denis-bisson/tusb2036-eval/README.md

Evaluation board for the TI TUSB2036 USB hub controller.
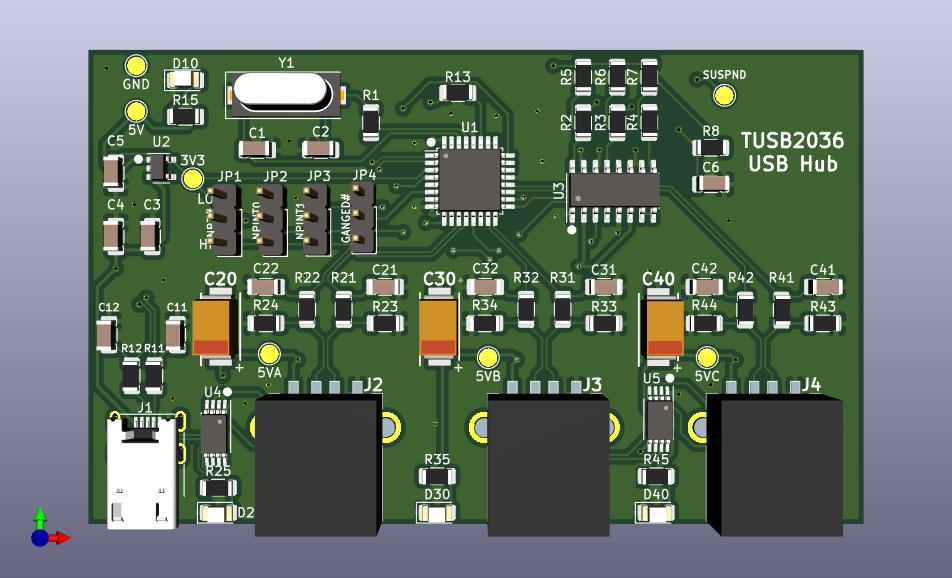
[picture p1: render.jpg]
Render
