denis-bisson/tusb2036-eval/bom.csv

Refs | value | Vendor | Vendor Part # | Price | datasheet | footprint
C1 | 22pF | Mouser | 710-885012009007 | 0.61 | https://www.mouser.com/datasheet/2/445/885012009007-1727300.pdf | Capacitor_SMD:C_1206_3216Metric
C10 | 22pF | Mouser | 710-885012009007 | 0.61 | https://www.mouser.com/datasheet/2/445/885012009007-1727300.pdf | Capacitor_SMD:C_1206_3216Metric
C11 | 22pF | Mouser | 710-885012009007 | 0.61 | https://www.mouser.com/datasheet/2/445/885012009007-1727300.pdf | Capacitor_SMD:C_1206_3216Metric
C2 | 22pF | Mouser | 710-885012009007 | 0.61 | https://www.mouser.com/datasheet/2/445/885012009007-1727300.pdf | Capacitor_SMD:C_1206_3216Metric
C20 | 120μF | Mouser | 74-293D127X96R3D2TE3 | 0.87 | https://www.mouser.com/datasheet/2/427/293d-1763499.pdf | Vishay:CAPPM7343X310N
C21 | 22pF | Mouser | 710-885012009007 | 0.61 | https://www.mouser.com/datasheet/2/445/885012009007-1727300.pdf | Capacitor_SMD:C_1206_3216Metric
C22 | 22pF | Mouser | 710-885012009007 | 0.61 | https://www.mouser.com/datasheet/2/445/885012009007-1727300.pdf | Capacitor_SMD:C_1206_3216Metric
C3 | 4.7μF | Mouser | 80-C1210C475J3N | 0.93 | https://www.mouser.com/datasheet/2/212/KEM_C1008_X8L_150C_SMD-1101219.pdf | Capacitor_SMD:C_1206_3216Metric
C30 | 120μF | Mouser | 74-293D127X96R3D2TE3 | 0.87 | https://www.mouser.com/datasheet/2/427/293d-1763499.pdf | Vishay:CAPPM7343X310N
C31 | 22pF | Mouser | 710-885012009007 | 0.61 | https://www.mouser.com/datasheet/2/445/885012009007-1727300.pdf | Capacitor_SMD:C_1206_3216Metric
C32 | 22pF | Mouser | 710-885012009007 | 0.61 | https://www.mouser.com/datasheet/2/445/885012009007-1727300.pdf | Capacitor_SMD:C_1206_3216Metric
C4 | 0.1μF | Mouser | 581-12105C104JAT2A | 0.46 | https://www.mouser.com/datasheet/2/40/X7RDielectric-777024.pdf | Capacitor_SMD:C_1206_3216Metric
C40 | 120μF | Mouser | 74-293D127X96R3D2TE3 | 0.87 | https://www.mouser.com/datasheet/2/427/293d-1763499.pdf | Vishay:CAPPM7343X310N
C41 | 22pF | Mouser | 710-885012009007 | 0.61 | https://www.mouser.com/datasheet/2/445/885012009007-1727300.pdf | Capacitor_SMD:C_1206_3216Metric
C42 | 22pF | Mouser | 710-885012009007 | 0.61 | https://www.mouser.com/datasheet/2/445/885012009007-1727300.pdf | Capacitor_SMD:C_1206_3216Metric
C5 | 4.7μF | Mouser | 80-C1210C475J3N | 0.93 | https://www.mouser.com/datasheet/2/212/KEM_C1008_X8L_150C_SMD-1101219.pdf | Capacitor_SMD:C_1206_3216Metric
J1 | USB_B_Micro | Mouser | 490-UJ2-MIBH-4-SMT | 0.79 | https://www.mouser.com/datasheet/2/670/uj2_mibh_4_smt-1313358.pdf | CUI:UJ2-MIBH-4-SMT
J2 | USB_A | Mouser | 710-62900416021 | 2.36 | https://www.mouser.com/datasheet/2/445/62900416021-1718169.pdf | Wurth:62900416021
J3 | USB_A | Mouser | 710-62900416021 | 2.36 | https://www.mouser.com/datasheet/2/445/62900416021-1718169.pdf | Wurth:62900416021
J4 | USB_A | Mouser | 710-62900416021 | 2.36 | https://www.mouser.com/datasheet/2/445/62900416021-1718169.pdf | Wurth:62900416021
JP1 | NP3_SEL | Mouser | 649-1012937890301BLF | 0.1 | https://www.amphenol-icc.com/media/wysiwyg/files/documentation/datasheet/boardwiretoboard/bwb_econostik_254headers.pdf | Connector_PinHeader_2.54mm:PinHeader_1x03_P2.54mm_Vertical
JP2 | NPINT0_SEL | Mouser | 649-1012937890301BLF | 0.1 | https://www.amphenol-icc.com/media/wysiwyg/files/documentation/datasheet/boardwiretoboard/bwb_econostik_254headers.pdf | Connector_PinHeader_2.54mm:PinHeader_1x03_P2.54mm_Vertical
JP3 | NPINT1_SEL | Mouser | 649-1012937890301BLF | 0.1 | https://www.amphenol-icc.com/media/wysiwyg/files/documentation/datasheet/boardwiretoboard/bwb_econostik_254headers.pdf | Connector_PinHeader_2.54mm:PinHeader_1x03_P2.54mm_Vertical
JP4 | GANGED_SEL | Mouser | 649-1012937890301BLF | 0.1 | https://www.amphenol-icc.com/media/wysiwyg/files/documentation/datasheet/boardwiretoboard/bwb_econostik_254headers.pdf | Connector_PinHeader_2.54mm:PinHeader_1x03_P2.54mm_Vertical
R1 | 1.5kΩ | Mouser | 603-RC1210FR-071K5L | 0.14 | https://www.mouser.com/datasheet/2/447/PYu_RC_Group_51_RoHS_L_10-1664068.pdf | Resistor_SMD:R_1206_3216Metric
R10 | 27Ω | Mouser | 603-RC1210FR-0727RL | 0.14 | https://www.mouser.com/datasheet/2/447/PYu_RC_Group_51_RoHS_L_10-1664068.pdf | Resistor_SMD:R_1206_3216Metric
R11 | 27Ω | Mouser | 603-RC1210FR-0727RL | 0.14 | https://www.mouser.com/datasheet/2/447/PYu_RC_Group_51_RoHS_L_10-1664068.pdf | Resistor_SMD:R_1206_3216Metric
R2 | 1.5kΩ | Mouser | 603-RC1210FR-071K5L | 0.14 | https://www.mouser.com/datasheet/2/447/PYu_RC_Group_51_RoHS_L_10-1664068.pdf | Resistor_SMD:R_1206_3216Metric
R21 | 27Ω | Mouser | 603-RC1210FR-0727RL | 0.14 | https://www.mouser.com/datasheet/2/447/PYu_RC_Group_51_RoHS_L_10-1664068.pdf | Resistor_SMD:R_1206_3216Metric
R22 | 27Ω | Mouser | 603-RC1210FR-0727RL | 0.14 | https://www.mouser.com/datasheet/2/447/PYu_RC_Group_51_RoHS_L_10-1664068.pdf | Resistor_SMD:R_1206_3216Metric
R23 | 15kΩ | Mouser | 603-RC1210FR-0715KL | 0.16 | https://www.mouser.com/datasheet/2/447/PYu_RC_Group_51_RoHS_L_10-1664068.pdf | Resistor_SMD:R_1206_3216Metric
R24 | 15kΩ | Mouser | 603-RC1210FR-0715KL | 0.16 | https://www.mouser.com/datasheet/2/447/PYu_RC_Group_51_RoHS_L_10-1664068.pdf | Resistor_SMD:R_1206_3216Metric
R3 | 15kΩ | Mouser | 603-RC1210FR-0715KL | 0.16 | https://www.mouser.com/datasheet/2/447/PYu_RC_Group_51_RoHS_L_10-1664068.pdf | Resistor_SMD:R_1206_3216Metric
R31 | 27Ω | Mouser | 603-RC1210FR-0727RL | 0.14 | https://www.mouser.com/datasheet/2/447/PYu_RC_Group_51_RoHS_L_10-1664068.pdf | Resistor_SMD:R_1206_3216Metric
R32 | 27Ω | Mouser | 603-RC1210FR-0727RL | 0.14 | https://www.mouser.com/datasheet/2/447/PYu_RC_Group_51_RoHS_L_10-1664068.pdf | Resistor_SMD:R_1206_3216Metric
R33 | 15kΩ | Mouser | 603-RC1210FR-0715KL | 0.16 | https://www.mouser.com/datasheet/2/447/PYu_RC_Group_51_RoHS_L_10-1664068.pdf | Resistor_SMD:R_1206_3216Metric
R34 | 15kΩ | Mouser | 603-RC1210FR-0715KL | 0.16 | https://www.mouser.com/datasheet/2/447/PYu_RC_Group_51_RoHS_L_10-1664068.pdf | Resistor_SMD:R_1206_3216Metric
R41 | 27Ω | Mouser | 603-RC1210FR-0727RL | 0.14 | https://www.mouser.com/datasheet/2/447/PYu_RC_Group_51_RoHS_L_10-1664068.pdf | Resistor_SMD:R_1206_3216Metric
R42 | 27Ω | Mouser | 603-RC1210FR-0727RL | 0.14 | https://www.mouser.com/datasheet/2/447/PYu_RC_Group_51_RoHS_L_10-1664068.pdf | Resistor_SMD:R_1206_3216Metric
R43 | 15kΩ | Mouser | 603-RC1210FR-0715KL | 0.16 | https://www.mouser.com/datasheet/2/447/PYu_RC_Group_51_RoHS_L_10-1664068.pdf | Resistor_SMD:R_1206_3216Metric
R44 | 15kΩ | Mouser | 603-RC1210FR-0715KL | 0.16 | https://www.mouser.com/datasheet/2/447/PYu_RC_Group_51_RoHS_L_10-1664068.pdf | Resistor_SMD:R_1206_3216Metric
SW1 | RESET | Mouser | 653-B3FS-1002P | 0.58 | https://www.mouser.com/datasheet/2/307/omron_B3FS-1189765.pdf | Omron:SW_SPST_Omron_B3FS-100xP
U1 | TUSB2036 | Mouser | 595-TUSB2036VFR | 3.4 | http://www.ti.com/lit/ds/symlink/tusb2036.pdf | Package_QFP:LQFP-32_7x7mm_P0.8mm
U2 | TPS76333 | Mouser | 595-PS76333QDBVRG4Q1 | 1 | http://www.ti.com/lit/ds/symlink/tps763.pdf | Package_TO_SOT_SMD:SOT-23-5
U3 | TPS2044D | Mouser | 595-TPS2044BDR | 2.73 | http://www.ti.com/lit/ds/symlink/tps2044.pdf | Package_SO:SOIC-16_3.9x9.9mm_P1.27mm
U4 | SN75240 | Mouser | 595-SN75240PWR | 1.31 | http://www.ti.com/lit/ds/symlink/sn65220.pdf | Package_SO:TSSOP-8_4.4x3mm_P0.65mm
U5 | SN75240 | Mouser | 595-SN75240PWR | 1.31 | http://www.ti.com/lit/ds/symlink/sn65220.pdf | Package_SO:TSSOP-8_4.4x3mm_P0.65mm
Y1 | 6MHz | Mouser | 73-XT49M600-20 | 0.95 | https://www.mouser.com/datasheet/2/427/xt49m-1763016.pdf | Crystal:Crystal_SMD_HC49-SD
C12 | 22pF | Mouser | 710-885012009007 | 0.61 | https://www.mouser.com/datasheet/2/445/885012009007-1727300.pdf | Capacitor_SMD:C_1206_3216Metric
D10 | VBUS | Mouser | 604-AP3216ID | 0.28 | https://www.mouser.com/datasheet/2/216/ap3216id-1173252.pdf | LED_SMD:LED_1206_3216Metric
D20 | 5VA | Mouser | 604-AP3216ID | 0.28 | https://www.mouser.com/datasheet/2/216/ap3216id-1173252.pdf | LED_SMD:LED_1206_3216Metric
D30 | 5VB | Mouser | 604-AP3216ID | 0.28 | https://www.mouser.com/datasheet/2/216/ap3216id-1173252.pdf | LED_SMD:LED_1206_3216Metric
D40 | 5VC | Mouser | 604-AP3216ID | 0.28 | https://www.mouser.com/datasheet/2/216/ap3216id-1173252.pdf | LED_SMD:LED_1206_3216Metric
LOGO1 | Logo_Open_Hardware_Small | - | - | 0 | - | Symbol:OSHW-Logo2_9.8x8mm_SilkScreen
R12 | 27Ω | Mouser | 603-RC1210FR-0727RL | 0.14 | https://www.mouser.com/datasheet/2/447/PYu_RC_Group_51_RoHS_L_10-1664068.pdf | Resistor_SMD:R_1206_3216Metric
R15 | 330Ω | Mouser | 667-ERJ-8ENF3300V | 0.10 | https://www.mouser.com/datasheet/2/315/AOA0000C304-1149620.pdf | Resistor_SMD:R_1206_3216Metric
R25 | 330Ω | Mouser | 667-ERJ-8ENF3300V | 0.10 | https://www.mouser.com/datasheet/2/315/AOA0000C304-1149620.pdf | Resistor_SMD:R_1206_3216Metric
R35 | 330Ω | Mouser | 667-ERJ-8ENF3300V | 0.10 | https://www.mouser.com/datasheet/2/315/AOA0000C304-1149620.pdf | Resistor_SMD:R_1206_3216Metric
R45 | 330Ω | Mouser | 667-ERJ-8ENF3300V | 0.10 | https://www.mouser.com/datasheet/2/315/AOA0000C304-1149620.pdf | Resistor_SMD:R_1206_3216Metric
TP1 | GND | - | - | 0 | - | TestPoint:TestPoint_Pad_D2.0mm
TP2 | 5V | - | - | 0 | - | TestPoint:TestPoint_Pad_D2.0mm
TP3 | 5VA | - | - | 0 | - | TestPoint:TestPoint_Pad_D2.0mm
TP4 | 5VB | - | - | 0 | - | TestPoint:TestPoint_Pad_D2.0mm
TP5 | 5VC | - | - | 0 | - | TestPoint:TestPoint_Pad_D2.0mm
TP6 | SUSPND | - | - | 0 | - | TestPoint:TestPoint_Pad_D2.0mm
TP7 | 3V3 | - | - | 0 | - | TestPoint:TestPoint_Pad_D2.0mm
