denis-bisson/tusb2036-eval/tusb2036-eval.pdf

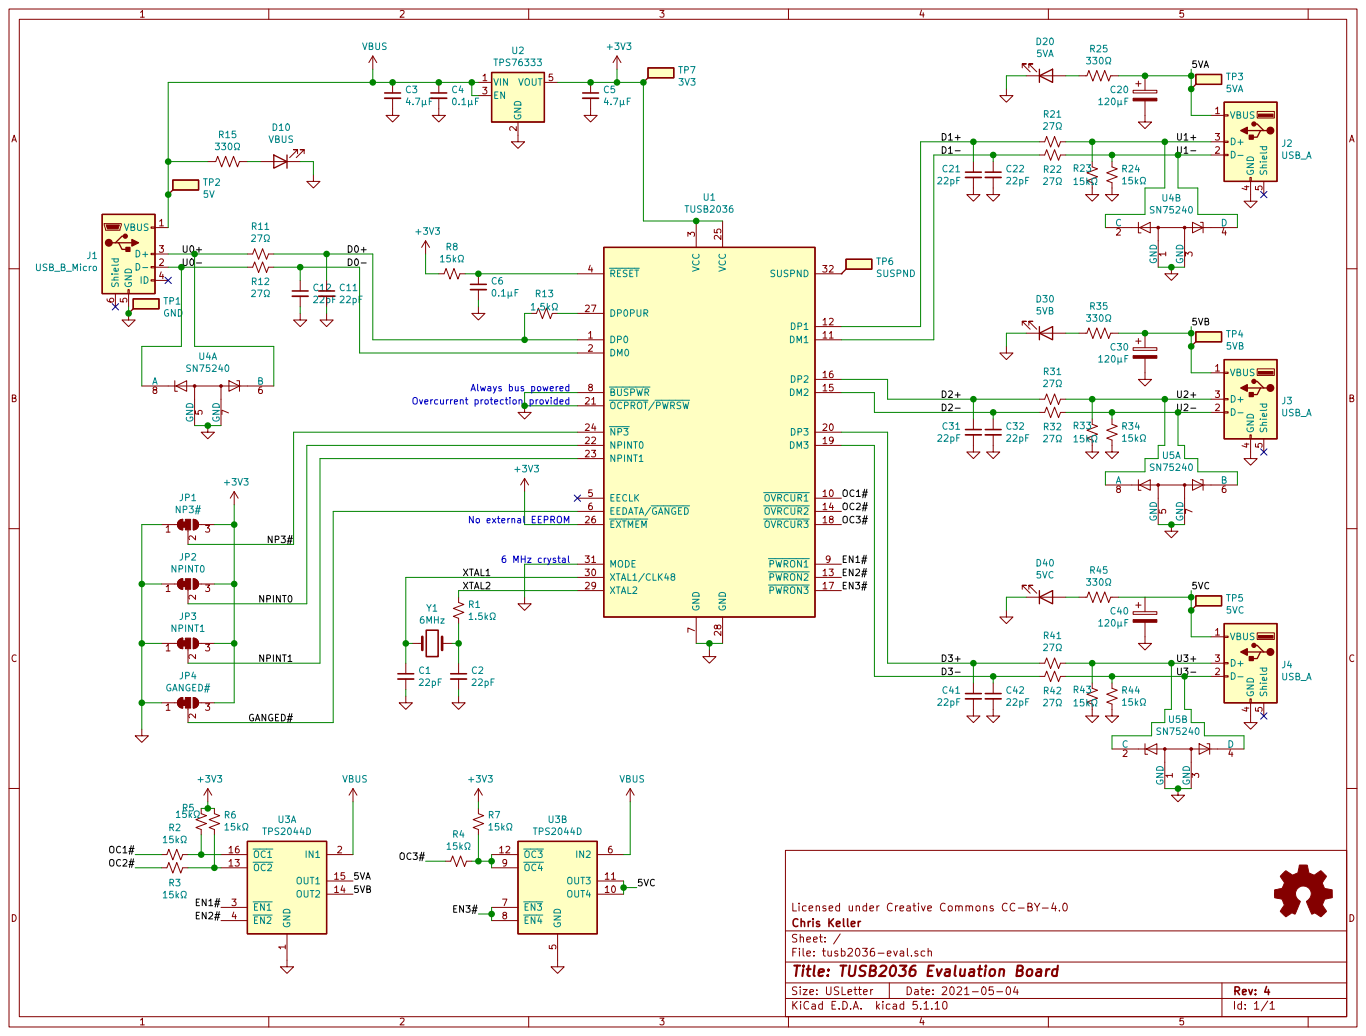
[picture p2: page 1]

3 XTAL1/CLK48 30 MODE 31 SUSPND 32 RESET 4 EECLK 5 EEDATA/GANGED 6 GND

File: tusb2036-eval.sch Sheet: / Chris Keller Licensed under Creative Commons CC-BY-4.0

Id: 1/1 Title: TUSB2036 Evaluation Board
