denis-bisson/tusb2036-eval/tusb2036-eval.kicad_pcb

## KiCad design tusb2036-eval.kicad_pcb (2021-05-04)

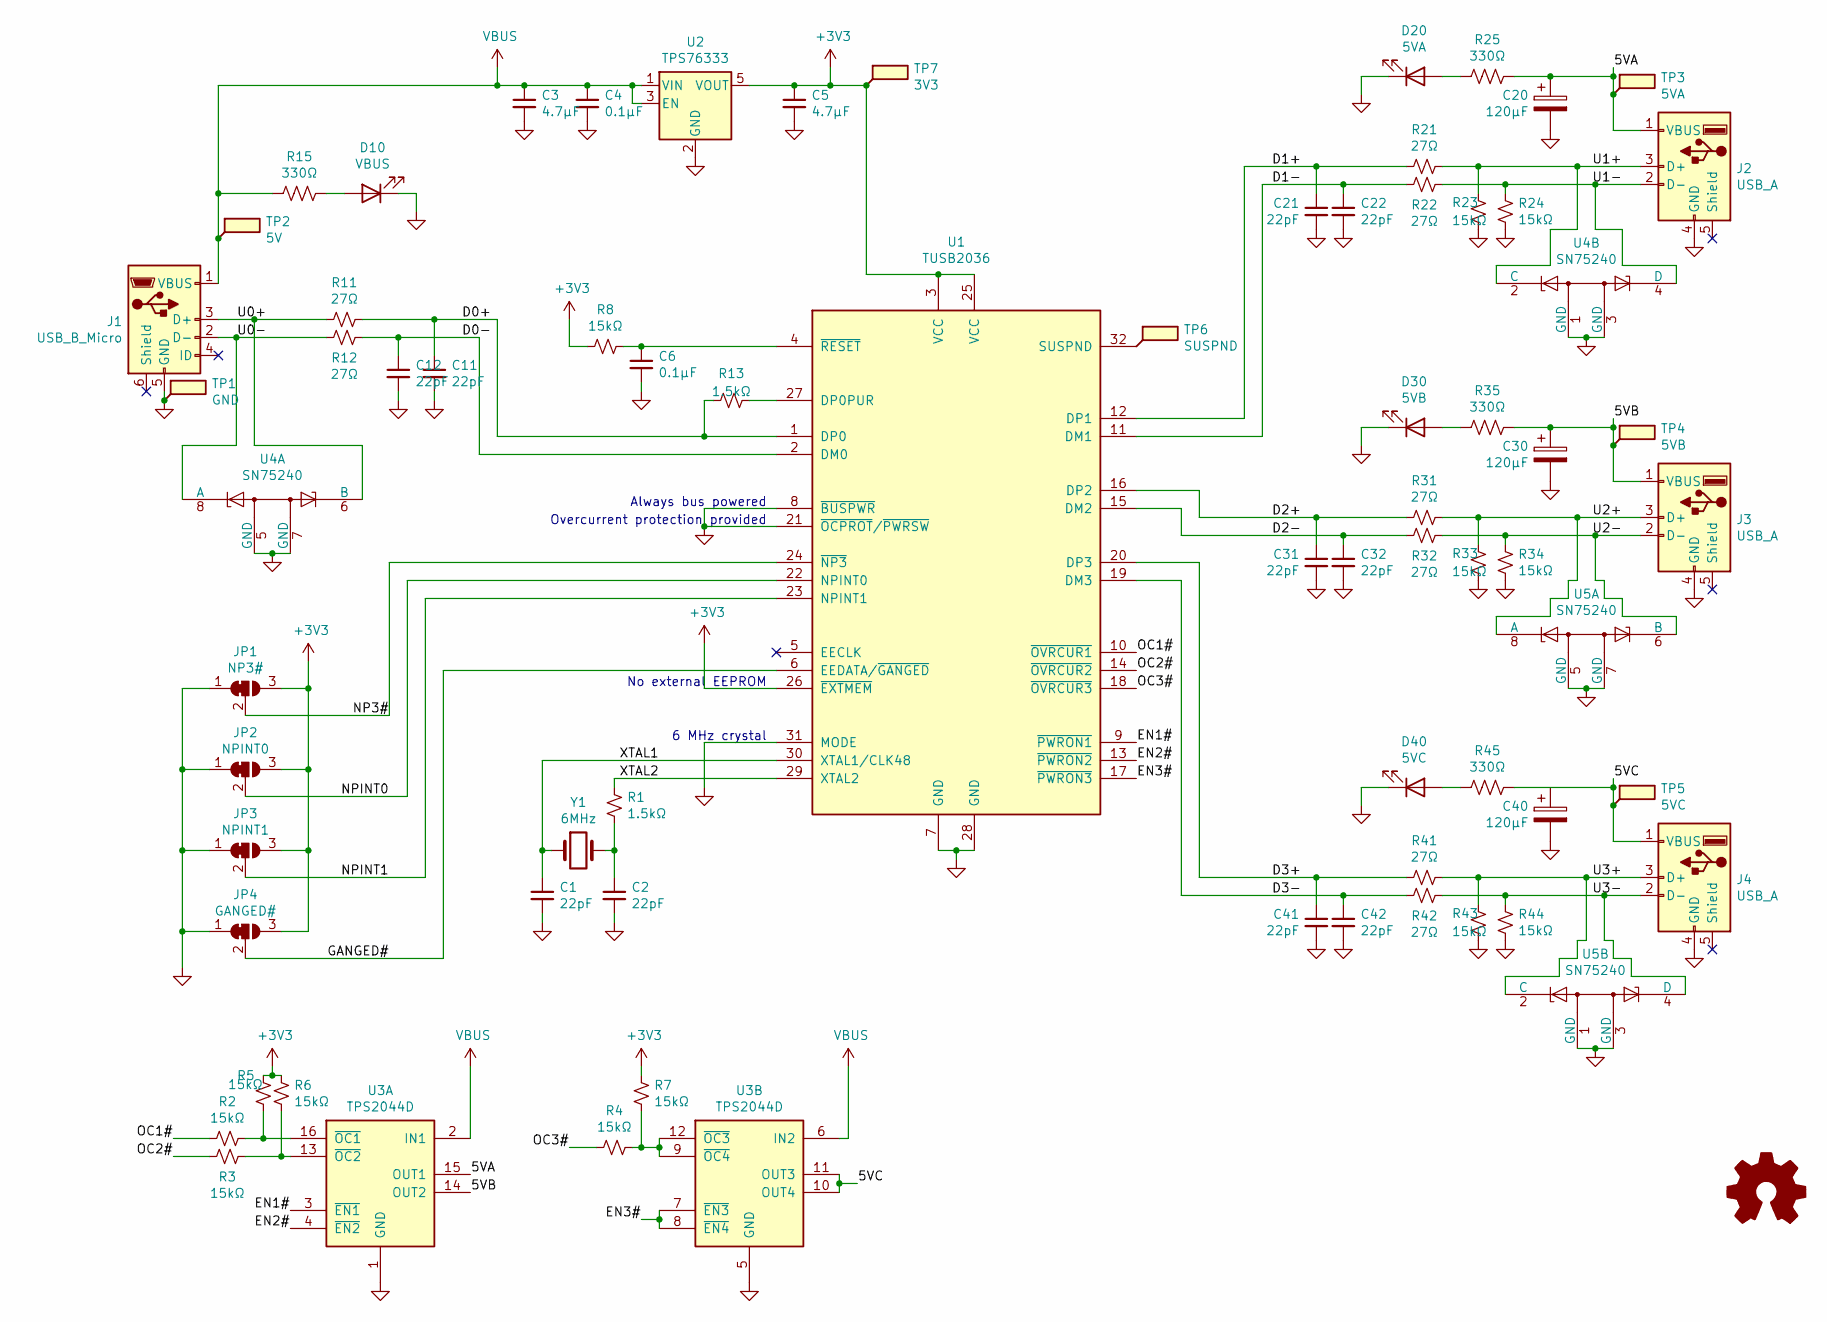
[picture p3: schematic tusb2036-eval.sch, TUSB2036 Evaluation Board]

Parts:
C1, C2, C11, C12, C21, C22, C31, C32, C41, C42: 22pF; C_1206_3216Metric
C3, C5: 4.7μF; C_1206_3216Metric
C4, C6: 0.1μF; C_1206_3216Metric
C20, C30, C40: 120μF; CAPPM7343X310N
D10: VBUS; LED_1206_3216Metric
D20: 5VA; LED_1206_3216Metric
D30: 5VB; LED_1206_3216Metric
D40: 5VC; LED_1206_3216Metric
J1: USB_B_Micro; UJ2-MIBH-4-SMT
J2, J3, J4: USB_A; 62900416021
JP1: NP3#; PinHeader_1x03_P2.54mm_Vertical
JP2: NPINT0; PinHeader_1x03_P2.54mm_Vertical
JP3: NPINT1; PinHeader_1x03_P2.54mm_Vertical
JP4: GANGED#; PinHeader_1x03_P2.54mm_Vertical
LOGO1: Logo_Open_Hardware_Small; OSHW-Logo2_9.8x8mm_SilkScreen
R1, R13: 1.5kΩ; R_1206_3216Metric
R2, R3, R4, R5, R6, R7, R8, R23, R24, R33, R34, R43, R44: 15kΩ; R_1206_3216Metric
R11, R12, R21, R22, R31, R32, R41, R42: 27Ω; R_1206_3216Metric
R15, R25, R35, R45: 330Ω; R_1206_3216Metric
TP1: GND; TestPoint_Pad_D2.0mm
TP2: 5V; TestPoint_Pad_D2.0mm
TP3: 5VA; TestPoint_Pad_D2.0mm
TP4: 5VB; TestPoint_Pad_D2.0mm
TP5: 5VC; TestPoint_Pad_D2.0mm
TP6: SUSPND; TestPoint_Pad_D2.0mm
TP7: 3V3; TestPoint_Pad_D2.0mm
U1: TUSB2036; LQFP-32_7x7mm_P0.8mm
U2: TPS76333; SOT-23-5
U3: TPS2044D; SOIC-16_3.9x9.9mm_P1.27mm
U4, U5: SN75240; TSSOP-8_4.4x3mm_P0.65mm
Y1: 6MHz; Crystal_SMD_HC49-SD

Connections:
+3V3: C5.1, JP1.3 (B), JP2.3 (B), JP3.3 (B), JP4.3 (B), R5.2, R6.2, R7.2, R8.2, TP7.1, U1.3 (VCC), U1.25 (VCC), U1.26 (~EXTMEM), U2.5 (VOUT)
/5VA: C20.1, J2.1 (VBUS), R25.1, TP3.1, U3.15 (OUT1)
/5VB: C30.1, J3.1 (VBUS), R35.1, TP4.1, U3.14 (OUT2)
/5VC: C40.1, J4.1 (VBUS), R45.1, TP5.1, U3.10 (OUT4), U3.11 (OUT3)
/D0+: C11.1, R11.2, R13.2, U1.1 (DP0)
/D0-: C12.1, R12.2, U1.2 (DM0)
/D1+: C21.1, R21.1, U1.12 (DP1)
/D1-: C22.1, R22.1, U1.11 (DM1)
/D2+: C31.1, R31.1, U1.16 (DP2)
/D2-: C32.1, R32.1, U1.15 (DM2)
/D3+: C41.1, R41.1, U1.20 (DP3)
/D3-: C42.1, R42.1, U1.19 (DM3)
/EN1#: U1.9 (~PWRON1), U3.3 (~EN1)
/EN2#: U1.13 (~PWRON2), U3.4 (~EN2)
/EN3#: U1.17 (~PWRON3), U3.7 (~EN3), U3.8 (~EN4)
/GANGED#: JP4.2 (C), U1.6 (EEDATA/~GANGED)
/NP3#: JP1.2 (C), U1.24 (~NP3)
/NPINT0: JP2.2 (C), U1.22 (NPINT0)
/NPINT1: JP3.2 (C), U1.23 (NPINT1)
/OC1#: R2.2, U1.10 (~OVRCUR1)
/OC2#: R3.2, U1.14 (~OVRCUR2)
/OC3#: R4.2, U1.18 (~OVRCUR3)
/U0+: J1.3 (D+), R11.1, U4.6 (B)
/U0-: J1.2 (D-), R12.1, U4.8 (A)
/U1+: J2.3 (D+), R21.2, R23.1, U4.2 (C)
/U1-: J2.2 (D-), R22.2, R24.1, U4.4 (D)
/U2+: J3.3 (D+), R31.2, R33.1, U5.8 (A)
/U2-: J3.2 (D-), R32.2, R34.1, U5.6 (B)
/U3+: J4.3 (D+), R41.2, R43.1, U5.2 (C)
/U3-: J4.2 (D-), R42.2, R44.1, U5.4 (D)
/XTAL1: C1.1, U1.30 (XTAL1/CLK48), Y1.1
/XTAL2: R1.1, U1.29 (XTAL2)
GND: C1.2, C2.2, C3.2, C4.2, C5.2, C6.2, C11.2, C12.2, C20.2, C21.2, C22.2, C30.2, C31.2, C32.2, C40.2, C41.2, C42.2, D10.1 (K), D20.1 (K), D30.1 (K), D40.1 (K), J1.5 (GND), J2.4 (GND), J3.4 (GND), J4.4 (GND), JP1.1 (A), JP2.1 (A), JP3.1 (A), JP4.1 (A), R23.2, R24.2, R33.2, R34.2, R43.2, R44.2, TP1.1, U1.7 (GND), U1.8 (~BUSPWR), U1.21 (~OCPROT~/~PWRSW~), U1.28 (GND), U1.31 (MODE), U2.2 (GND), U3.1 (GND), U3.5 (GND), U4.1 (GND), U4.3 (GND), U4.5 (GND), U4.7 (GND), U5.1 (GND), U5.3 (GND), U5.5 (GND), U5.7 (GND)
unnamed: C2.1, R1.2, Y1.2
unnamed: C6.1, R8.1, U1.4 (~RESET)
unnamed: D10.2 (A), R15.1
unnamed: D20.2 (A), R25.2
unnamed: D30.2 (A), R35.2
unnamed: D40.2 (A), R45.2
unnamed: R2.1, R5.1, U3.16 (~OC1)
unnamed: R3.1, R6.1, U3.13 (~OC2)
unnamed: R4.1, R7.1, U3.9 (~OC4), U3.12 (~OC3)
unnamed: R13.1, U1.27 (DP0PUR)
unnamed: TP6.1, U1.32 (SUSPND)
VBUS: C3.1, C4.1, J1.1 (VBUS), R15.2, TP2.1, U2.1 (VIN), U2.3 (EN), U3.2 (IN1), U3.6 (IN2)

Notes on the sheet:
Always bus powered
Overcurrent protection provided
No external EEPROM
6 MHz crystal

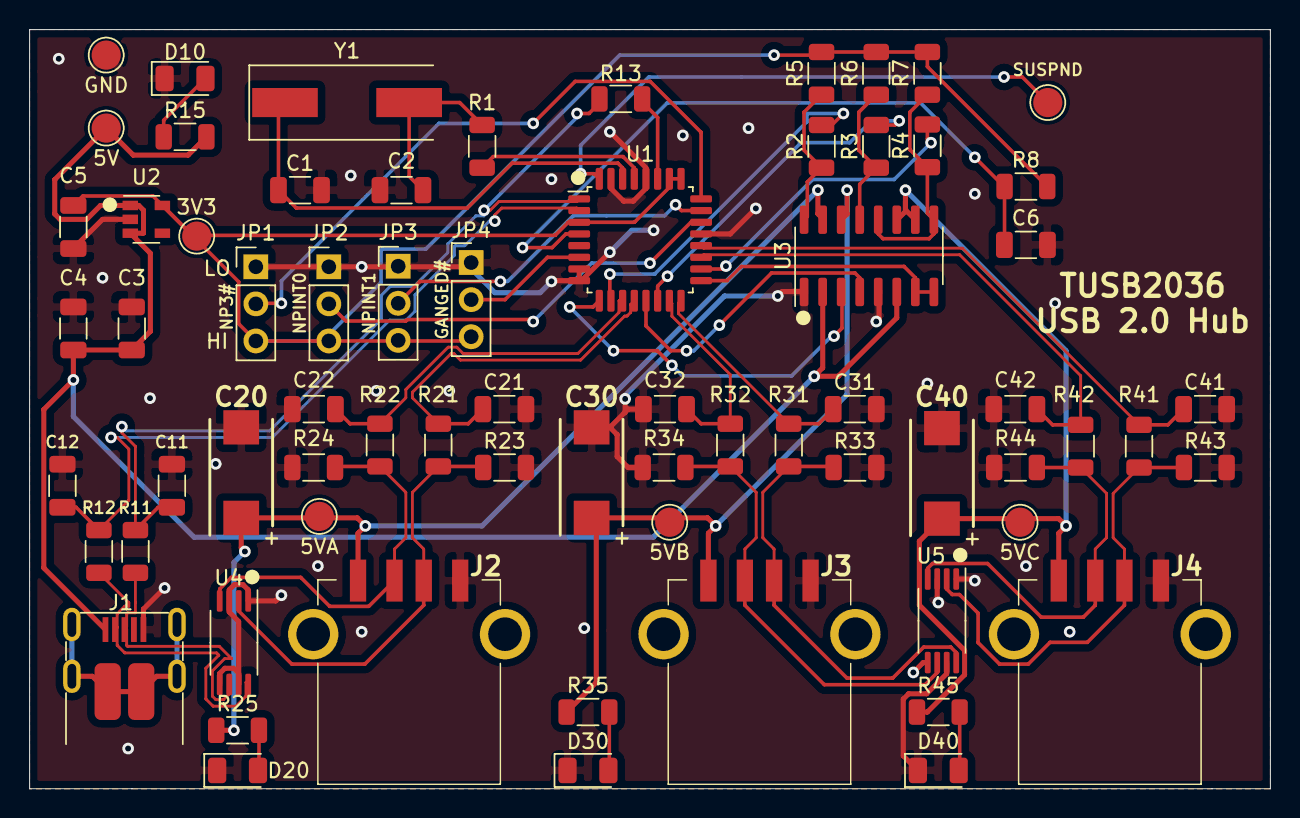
[picture p4: board tusb2036-eval.kicad_pcb from above]

Board: 2 copper layers, 85.0 x 52.0 mm, 70 parts (1 on the bottom side), 45 nets.
