denis-bisson/tusb2036-eval/(commit log)

2021-03-21 TUSB2036 Eval board v1
    [tusb2036-demo.kicad_pcb, tusb2036-demo.sch]
2021-03-21 Add schematic and render
    [tusb2036-demo.kicad_pcb]
2021-03-21 Fix 120uF caps
    [bom.csv, tusb2036-demo.kicad_pcb, tusb2036-demo.sch]
2021-03-21 Add shunts to BOM
    [bom.csv, tusb2036-demo.sch]
2021-03-23 Add R3 to disable TPS2044 OUT4
    [tusb2036-eval.kicad_pcb, tusb2036-eval.sch]
2021-03-23 Update BOM
    [bom.csv]
2021-04-04 Convert BOM from one per line to grouped
    [bom.csv]
2021-04-05 Thicker power traces and fix 3D models
    [tusb2036-eval.kicad_pcb, tusb2036-eval.sch]
2021-04-05 Add label for test point
    [tusb2036-eval.kicad_pcb]
2021-04-15 Add CC-BY-4.0 license
    [tusb2036-eval.kicad_pcb, tusb2036-eval.sch]
2021-04-15 Fix up libraries
    [tusb2036-eval.kicad_pcb, tusb2036-eval.sch]
2021-04-15 Replace micro USB connector
    The Molex is difficult to hand solder, so swapping that out for the CUI
    [bom.csv, tusb2036-eval.kicad_pcb, tusb2036-eval.sch]
2021-04-15 Add CUI USB 3D model
    [tusb2036-eval.kicad_pcb]
2021-04-16 Add test points
    [tusb2036-eval.kicad_pcb, tusb2036-eval.sch]
2021-04-19 Fix button footprint and other small updates
    [tusb2036-eval.kicad_pcb, tusb2036-eval.sch]
2021-04-19 Adjust silkscreen
    [tusb2036-eval.kicad_pcb]
2021-04-19 Fix BOM
    [bom.csv]
2021-04-24 Add OSHW logo
    [tusb2036-eval.kicad_pcb, tusb2036-eval.sch]
2021-04-27 Add LEDs
    [bom.csv, tusb2036-eval.kicad_pcb, tusb2036-eval.sch]
2021-04-28 Clean up schematic
    * Start using # for active-low nets
    * Rearrange config block for readability
    * Remove some pull-up resistors that I'm not sure about
    [tusb2036-eval.sch]
2021-04-28 Add some components from TUSB2036-EVL user guide
    [tusb2036-eval.sch]
2021-04-28 Implement overcurrent resistor changes
    [tusb2036-eval.kicad_pcb]
2021-05-04 Add RC filter for RESET
    Suggested by eevblog user pigrew and example schematic
    [tusb2036-eval.kicad_pcb, tusb2036-eval.sch]
